samuil4/USB-LTE4G-EU/HARDWARE/7-BOX-ASSEMBLY-3.png

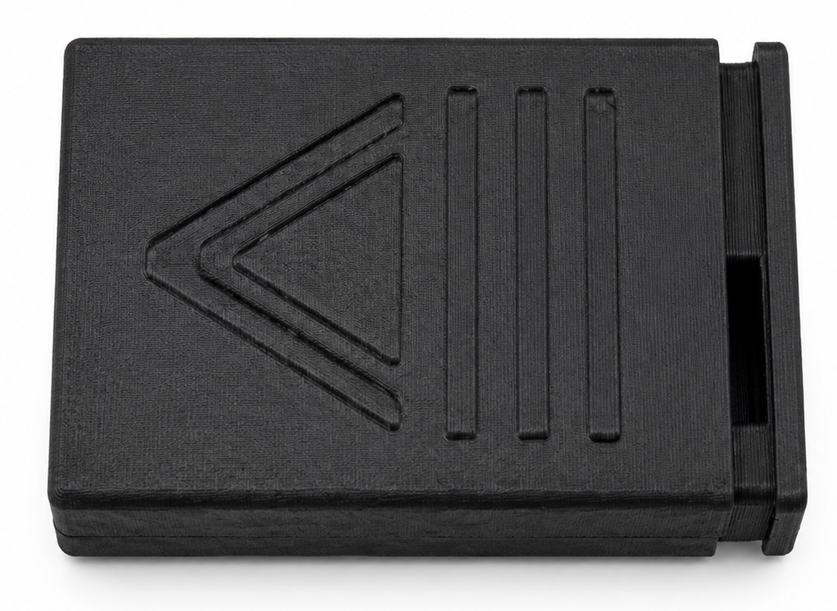
HARDWARE/7-BOX-ASSEMBLY-3.png
