samuil4/USB-LTE4G-EU/HARDWARE/5-BOX-ASSEMBLY-1.png

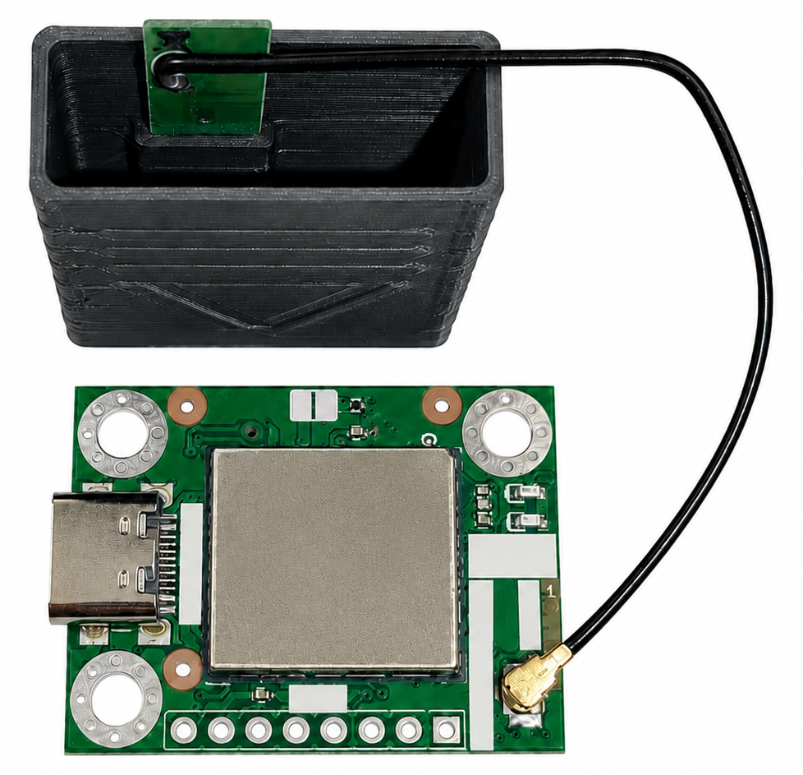
HARDWARE/5-BOX-ASSEMBLY-1.png
