samuil4/USB-LTE4G-EU/README.md

# USB-LTE4G-EU
USB LTE modem for IoT connectivity and industrial applications

Original design by Olimex, product page: https://www.olimex.com/Products/IoT/LTE/USB-LTE4G-EU-ANT/
