samuil4/USB-LTE4G-EU/HARDWARE/1-USB-LTE4G-EU_Rev_B_top.png

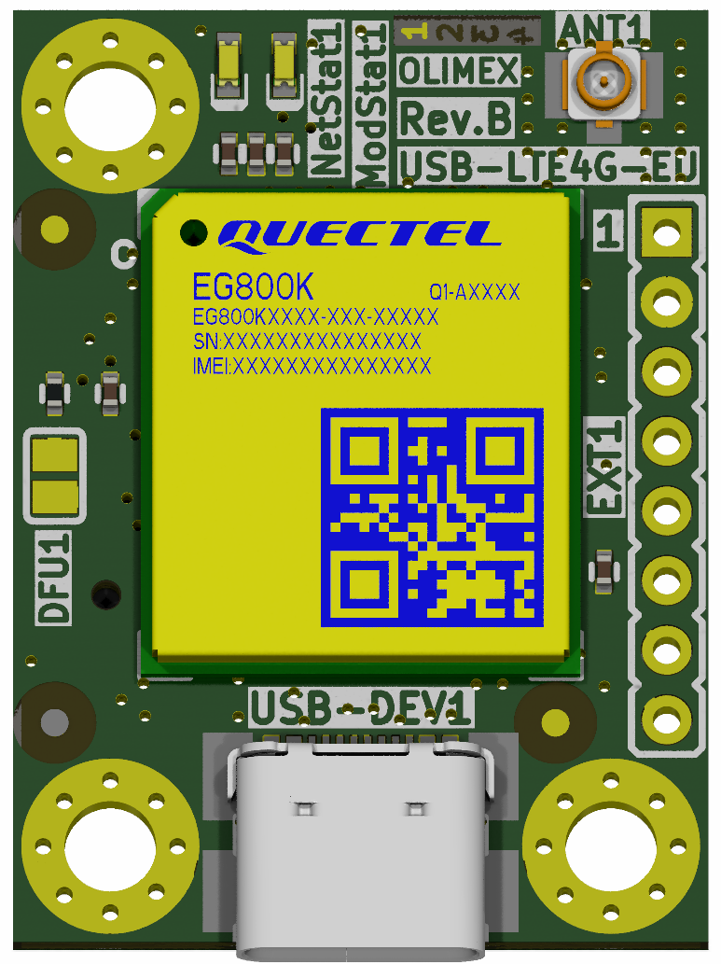
HARDWARE/1-USB-LTE4G-EU_Rev_B_top.png
