samuil4/USB-LTE4G-EU/HARDWARE/2-USB-LTE4G-EU_Rev_B_bottom.png

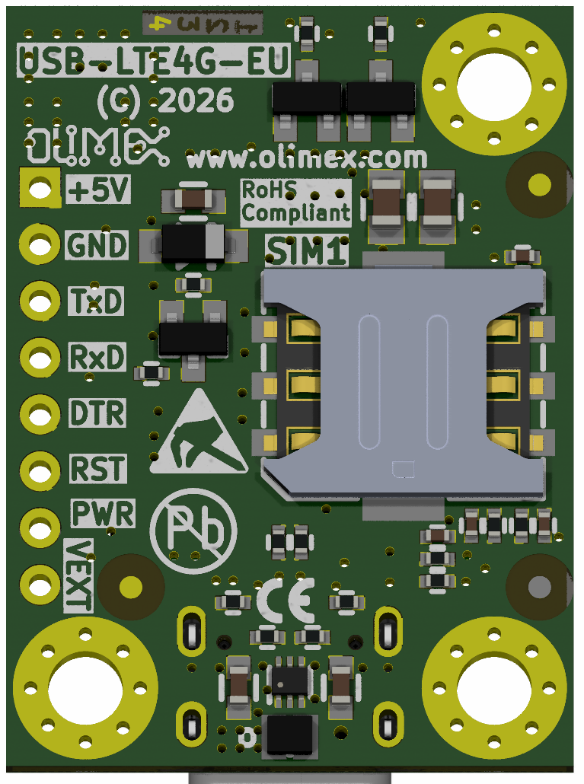
HARDWARE/2-USB-LTE4G-EU_Rev_B_bottom.png
