samuil4/USB-LTE4G-EU/HARDWARE/3-BOX-LTE4G.jpg

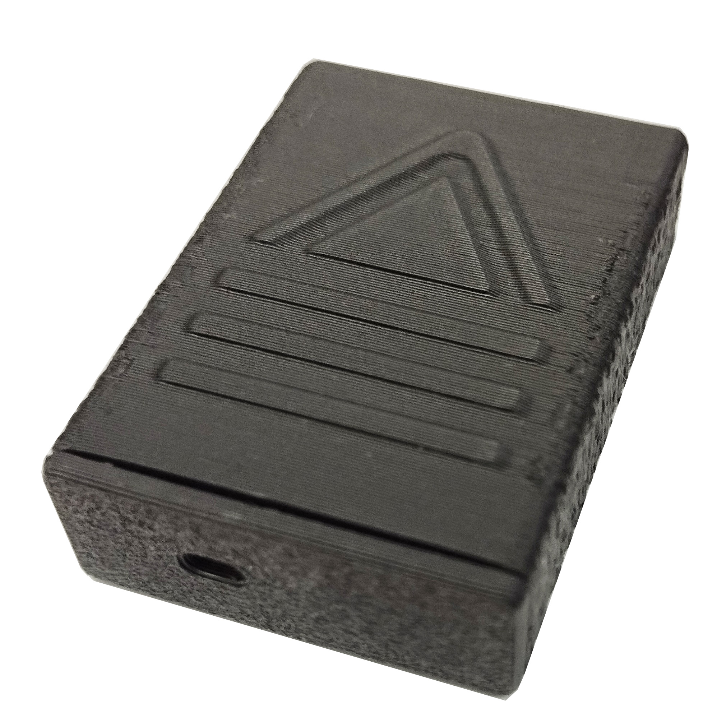
HARDWARE/3-BOX-LTE4G.jpg
