samuil4/USB-LTE4G-EU/HARDWARE/4-EXT1-USB-serial-L.png

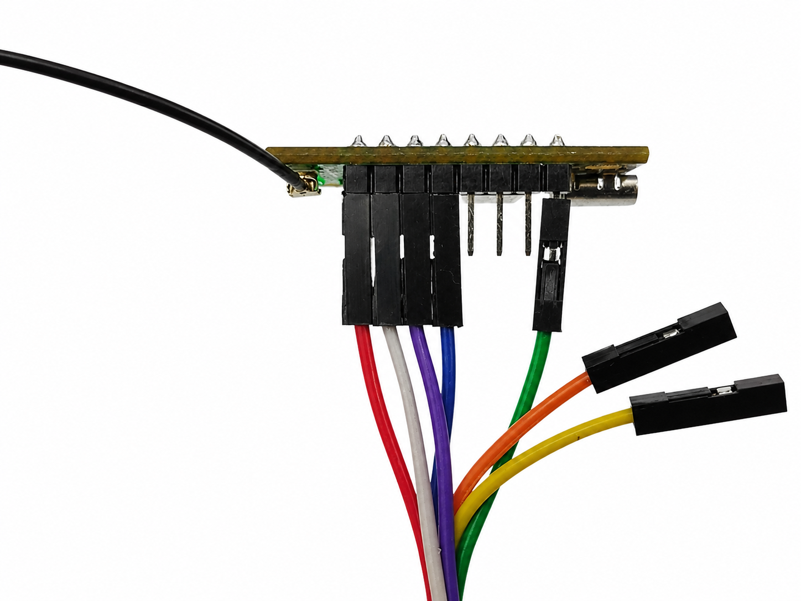
HARDWARE/4-EXT1-USB-serial-L.png
