samuil4/USB-LTE4G-EU/HARDWARE/BOX/usb-lte4g-eu v7 - 1pcs.3mf

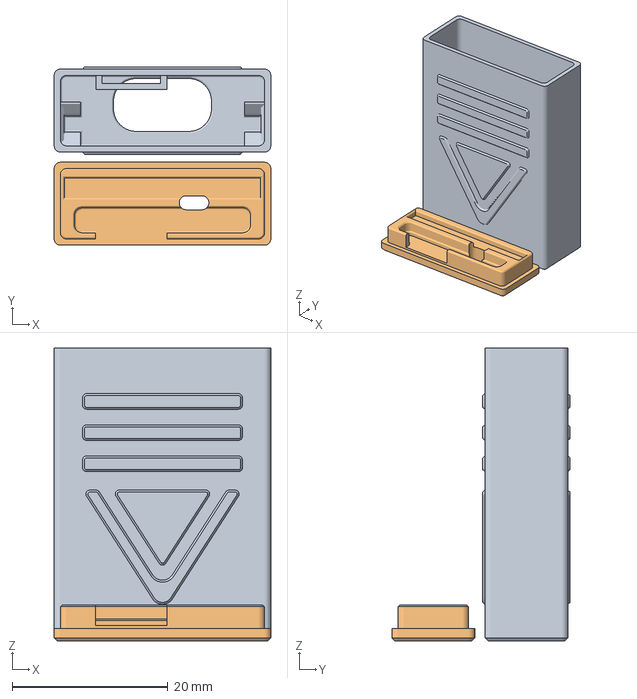
[picture p7: CAD file, 2026-06-25]
HARDWARE/BOX/usb-lte4g-eu v7 - 1pcs.3mf
27.8 x 22.9 x 37.6 mm
usb-lte4g-eu.stl_1
usb-lte4g-eu.stl_2
