samuil4/USB-LTE4G-EU/(list of files, cad)

Other CAD files:
HARDWARE/BOX/usb-lte4g-eu v7 - 1pcs.stl
