samuil4/USB-LTE4G-EU/HARDWARE/6-BOX-ASSEMBLY-2.png

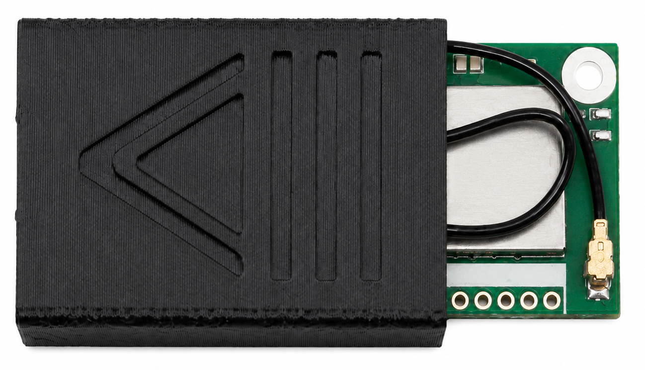
HARDWARE/6-BOX-ASSEMBLY-2.png
