samuil4/USB-LTE4G-EU/(commit log)

2026-06-09 Update
    Linux drivers
2026-06-25 adding 3mf and stl files for 3D printed box
    [usb-lte4g-eu v7 - 1pcs.3mf, usb-lte4g-eu v7 - 1pcs.stl]
